JonathanBencke/VCortex-Hardware/(commit log)

2026-03-31 Initial commit: V-Cortex Hardware — KiCad schematic + BOM JLCPCB
    - KiCad 10 hierarchical schematic (5 sheets): pwr, mcu, usb, can_kline, periph
    - Engineering Guide com especificacoes completas de todos os subsistemas
    - BOM JLCPCB com ~97 componentes e codigos LCSC verificados
    - Layout Guide com regras de roteamento 4 camadas JLC04161H-7628
    Correcoes aplicadas pos-revisao senior:
    - GPIO mapping corrigido conforme Engineering Guide secao 2.2
    - 3 indutores separados: L1 (input filter), L_SW (Buck switch), L_FILT (pos-Buck)
    - R_BOT_BK corrigido 56.2k -> 18k (VOUT=4.99V)
    - R_S_H/R_S_L 10Ohm adicionados no barramento CAN (CRITICO)
    - C_DTR/C_RTS 100nF adicionados no circuito auto-prog (CRITICO)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
    [bom_stock_report.csv, bom_stock_report_final.csv, can_kline.kicad_sch, mcu.kicad_sch, periph.kicad_sch, pwr.kicad_sch, usb.kicad_sch, vcortex.kicad_sch]
2026-03-31 fix(schematics): sincronizar LCSC codes com BOM verificada — rev v1.2
    Propagacao das correcoes do stock checker para todos os 5 sheets KiCad.
    7 erros criticos de codigo LCSC corrigidos nas descricoes dos esquematicos:
    pwr.kicad_sch:
    - Q1: C2976873 -> C53113978 (JSMSEMI PMV45EN2R-JSM, em estoque)
    - F1: C383507 -> C127824 (Littelfuse 1812L300MR, em estoque)
    - L1: C408444 -> C354625 (CENKER CKCS6028-10uH/M, em estoque)
    - C1: C428637 -> C3445238 (KNSCHA 100uF/50V D6.3x7mm, em estoque)
    - L_SW: VERIFY -> C5289366 (XR XRNR4030-4.7uH/M, em estoque)
    - R_BOOT_BK: C25741(10k!) -> C60491 (YAGEO 100k, 4.3M unid)
    - R_BOT_BK: VERIFY -> C25762 (UNI-ROYAL 18k 1%, 845k unid)
    - C_BOUT1/2: C5403 1206 -> C380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
    [can_kline.kicad_sch, mcu.kicad_sch, periph.kicad_sch, pwr.kicad_sch, usb.kicad_sch]
2026-03-31 docs(review): adicionar corrections.md com findings do hardware review rev v1.2
    Review comparativo entre esquemáticos KiCad, BOM JLCPCB e decisões de design.
    2 problemas críticos (C_GNSS_10N LCSC X7R vs NP0, Q1 VDS não verificado),
    3 altos (K-Line RX sem proteção, F1 polyfuse 30V, BOM desatualizada),
    4 médios (supply chain, footprint BAT1, VOUT Buck).
2026-03-31 fix(power): F1 polyfuse 30V->60V; documentar Q1 VDS verificado — rev v1.3
    F1: substituir 1812L300MR Littelfuse (30V) por MF-MSMF300/60-2 Bourns (60V).
    F1 fica upstream da TVS SMDJ22A (clamp 35.5V), logo ve o pico de load dump
    antes do clamp ativar — Vmax 30V era insuficiente.
    Q1: confirmar que JSMSEMI C53113978 tem VDS(max)=-40V (verificado no datasheet
    LCSC). Alertar que Nexperia C426872 tem VDS=-30V e NAO deve ser usado.
    [pwr.kicad_sch, vcortex_bom_jlcpcb.csv]
2026-03-31 fix(bom): renomear bom_resolved -> bom_v1_draft e marcar como obsoleto
    O arquivo vcortex_bom_resolved.csv tinha nome enganoso (sugeria arquivo final)
    mas continha valores pre-correcao: R_BOT_BK=56.2k, F1 sem LCSC, footprints 1206.
    Renomeado para vcortex_bom_v1_draft.csv com header de aviso.
    Arquivo de producao e vcortex_bom_jlcpcb.csv.
    [vcortex_bom_v1_draft.csv]
2026-03-31 fix(kline): adicionar divisor 10k/20k no KLINE_RX — rev v1.3
    L9637D pino RXD e saida 5V. GPIO33 (KLINE_RX) suporta max 3.3V.
    Sem divisor: GPIO33 seria danificado em operacao normal.
    Adicionados R_KRXA (10k, C60490) e R_KRXB (20k, C93942) formando
    divisor identico ao CAN_RX: V_GPIO33 = 5V * 20k/30k = 3.33V.
    U_LS1 (74LVC1T45) continua exclusivamente para TX (GPIO15->TXD).
    [can_kline.kicad_sch, vcortex_bom_jlcpcb.csv]
2026-03-31 fix(gnss): corrigir C_GNSS_10N — LCSC C15849 era X7R, deve ser NP0 — rev v1.3
    C_GNSS_10N (bypass VCC_IO NEO-M9N) estava com LCSC C15849 (Yageo X7R),
    o mesmo codigo de C_BOUT4. JLCPCB montaria X7R em ambos.
    NEO-M9N application note exige NP0/C0G no pino VCC_IO por estabilidade
    de capacitancia em 1575MHz (RF front-end). X7R tem variacao de ~80% com
    temperatura e tensao, comprometendo a performance do GNSS.
    MPN correto: Yageo CC0402JRNPO9BN103 (sufixo JRNPO = NP0).
    LCSC marcado como VERIFICAR_LCSC — obter codigo correto antes de ordernar.
    [periph.kicad_sch, vcortex_bom_jlcpcb.csv]
2026-03-31 docs(supply-chain): alertas de estoque NEO-M9N e L9637D — rev v1.3
    NEO-M9N-00B: documentar opcoes de sourcing (JLCPCB Global Sourcing,
    consignment via Mouser/DigiKey, alternativa NEO-M8N-0-10).
    L9637D (C153038): estoque ~1035 unidades — verificar antes de ordernar.
    Alternativa MC33290 (NXP) de pinagem compativel documentada.
    [can_kline.kicad_sch, periph.kicad_sch, vcortex_bom_jlcpcb.csv]
2026-03-31 fix(gnss): C_GNSS_10N LCSC resolvido — muRata C3855387 (C0G 10nF 0402)
    CC0402JRNPO9BN103 (Yageo NP0) nao disponivel na LCSC.
    Substituido por GRM1555C1E103JE01D (muRata, LCSC C3855387):
    - 10nF ±5% C0G/NP0, 0402, 25V
    - 16.000 unidades em estoque
    - $0.046/100 unidades
    C0G/NP0 obrigatorio no VCC_IO do NEO-M9N (RF front-end 1575MHz).
    [periph.kicad_sch, vcortex_bom_jlcpcb.csv]
2026-03-31 fix(kicad): corrigir sintaxe S-expression para abrir no KiCad 7/8
    - Remove comentários ;; (não suportados no formato S-expression do KiCad)
    - Adiciona ângulo ausente em todos os blocos (at X Y) → (at X Y 0)
    - Corrige vcortex.kicad_sch linha 121 (mesmo erro de ângulo)
    [can_kline.kicad_sch, mcu.kicad_sch, periph.kicad_sch, pwr.kicad_sch, usb.kicad_sch, vcortex.kicad_sch]
